zidanekarim/Project2DLD/(list of files, drawings)

Other design files:
Mod2Counter.circ
Mod4Counter.circ
readwriteram.circ
readwriteramtied.circ
